thearkadia/The_Ark/README.md

# The Ark - ¿Democracy's Favorite Device?

The Ark is a portable computer that can be upgraded, modded, or repaired by the user since it uses open-source software, the pcb files are available, and the parts can be purchased individually. It is powered by the [Raspberry Pi Compute Module](https://www.raspberrypi.org/products/compute-module-3-plus-lite/), and runs a modified version of Debian.

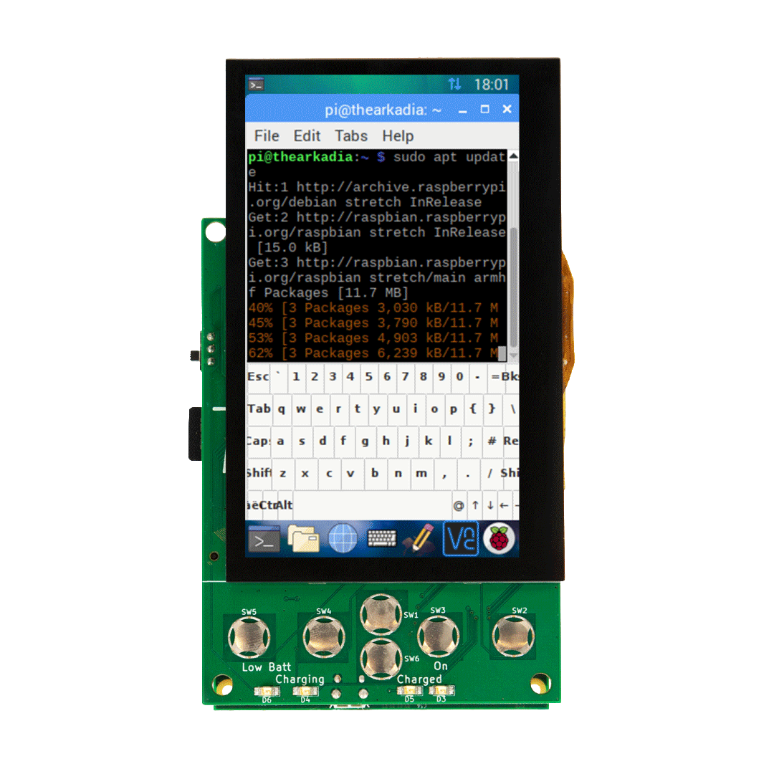
[picture p1: Media/arkscreens-final-whitebg.gif]
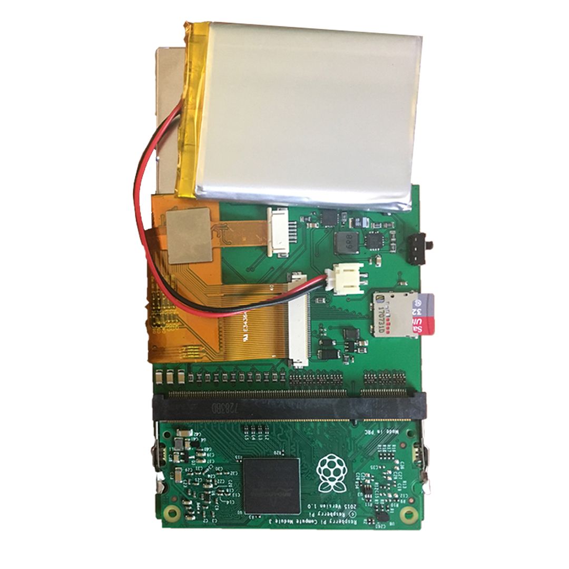
[picture p2: Media/ark-back.jpg]


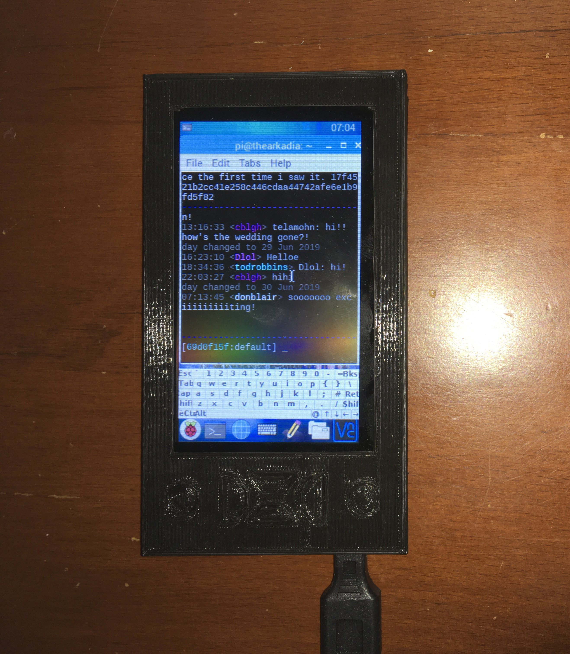
[picture p3: Media/ark-cabalchat.jpg]


# Simplifying Democracy
One of the goals of the Ark is to simplify the process of participating in a democracy for citizens, journalists, and politicians in a safe and transparent way. To simplify participating in a Democracy we will develop open source applications that focus on different key aspects of a Democracy. 

(images below are only mockups of the applications. all companies, charities, and names are used for demonstration purposes only) 

* An open source application that allows citizens to keep track of the voting history of their representatives. 

<p align="center">
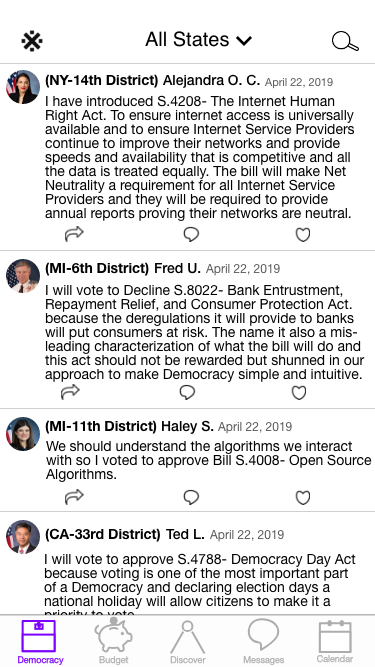
[picture p4: Media/PNGS/Posts@3x.png]
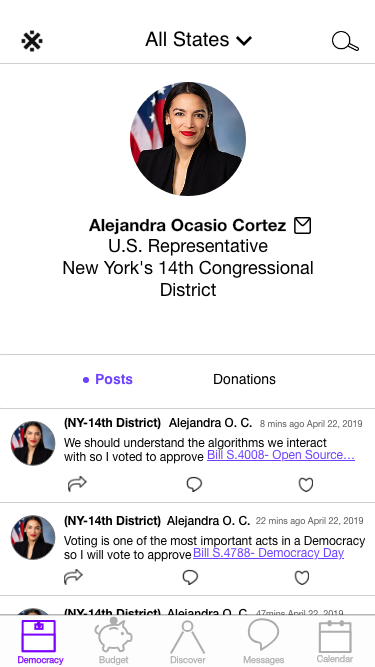
[picture p5: Media/PNGS/Profile Posts – 1@3x.png]
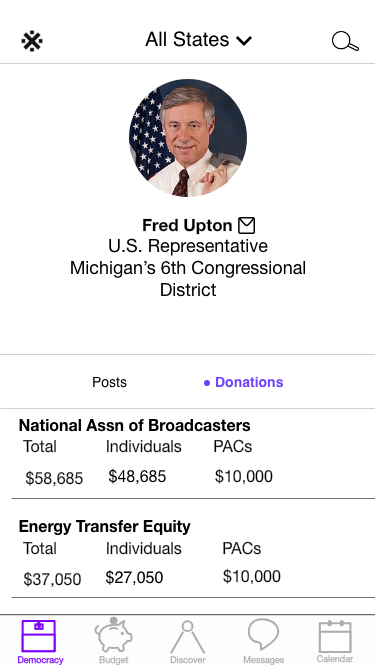
[picture p6: Media/PNGS/Profile Donations@3x.png]
       </p>

# Simplifying Budgets, Boycotts, and Taxes

* An application for journalists and charities to easily recieve reccuring donations from supporters. 

* An application to simplify the process of boycotting companies by displaying what products and companies a conglomerate owns or has a stake in. With a search feature to find alternatives to the product\service they are looking to purchase. 

<p align="center">
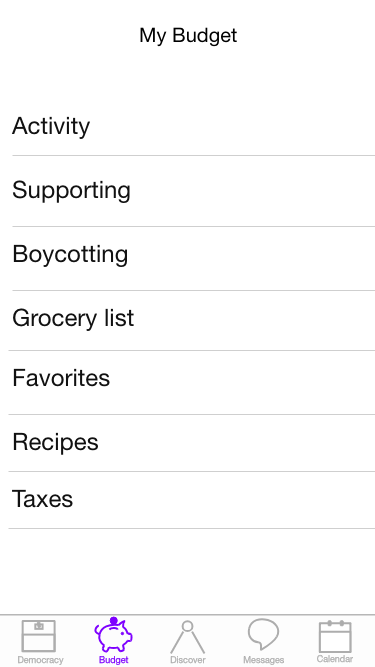
[picture p7: Media/PNGS/Budget@3x.png]

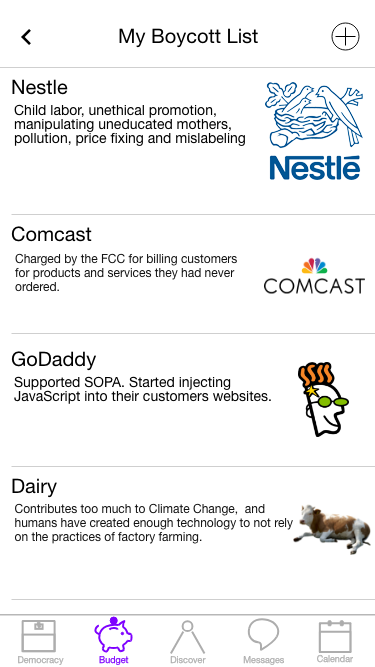
[picture p8: Media/PNGS/Boycott List@3x.png]
    
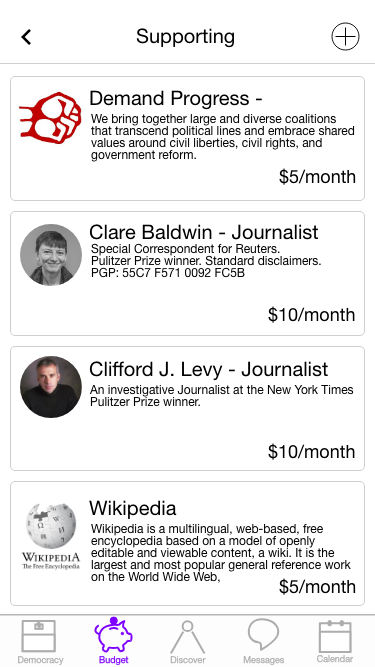
[picture p9: Media/PNGS/Supporting@3x.png]

</p>

<p align="center">
  
</p>

<p align="center">
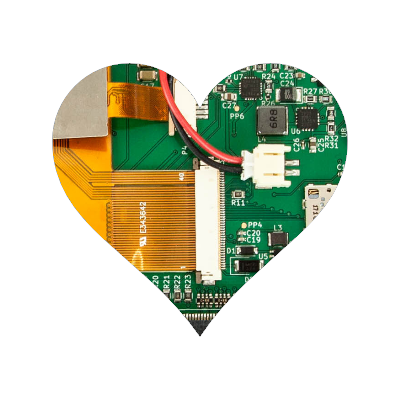
[picture p10: Media/ark-heart.png]
  
</p>
 <p align="center">
  <a href="mailto:nixoye@protonmail.com"></center>
Email Us</a> </p>

<p align="center"> <a href="https://www.crowdsupply.com/the-arkadia/the-ark-dev-kit"> Crowdsupply Campaign </center> </p></a>
<p>
 <p align="center">
  Follow us on <a href="https://instagram.com/thearkadia">Instagram </a> or <a href="http://www.twitter.com/nixoye">Twitter</a></p>
    
<p align="center">  It has to start somewhere. It has to start sometime.
      </center> 
 </p>

<p align="center"> What better place than here? What better time than now? </center>
