thearkadia/The_Ark/Media/3Dmodel/arkv1.png

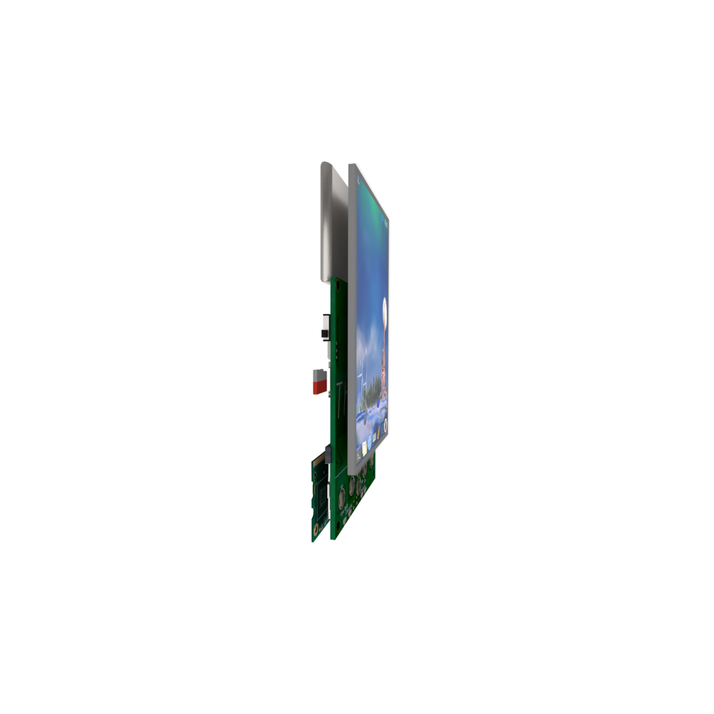
Media/3Dmodel/arkv1.png
