thearkadia/The_Ark/Media/arktitlecard.png

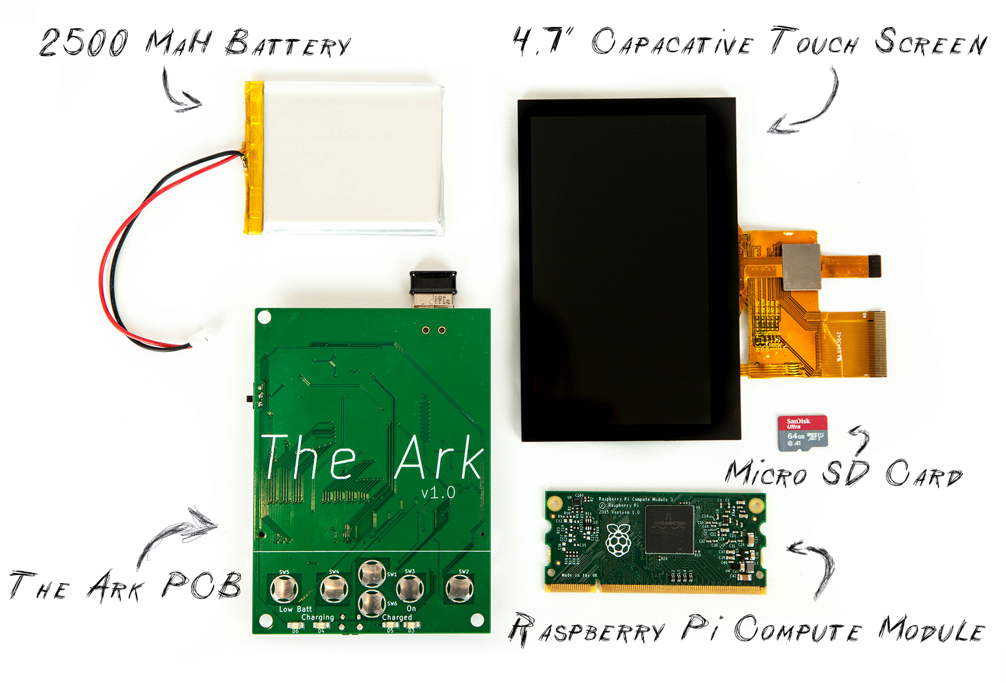
Media/arktitlecard.png
