thearkadia/The_Ark/Media/pcbimage2.png

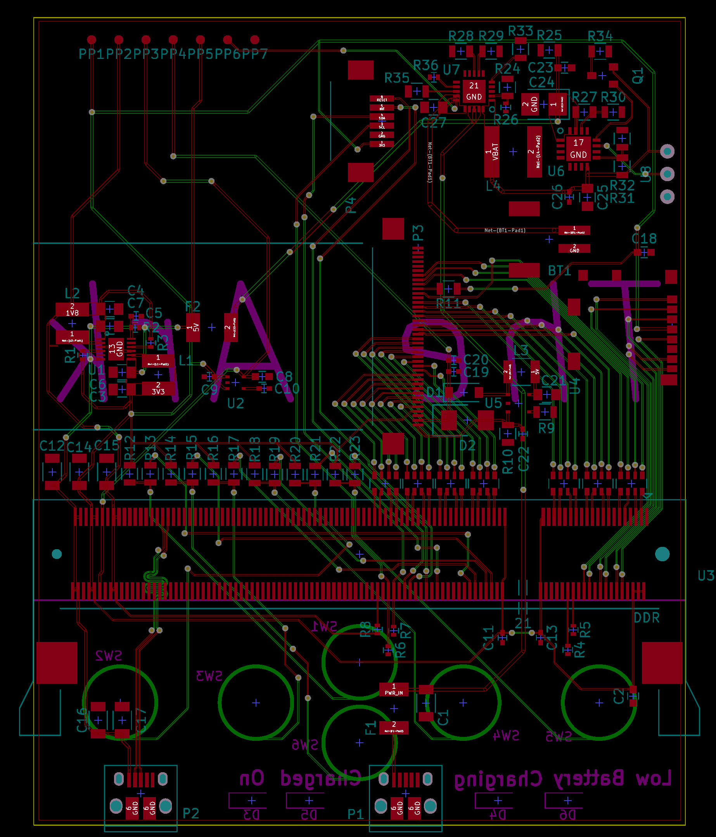
Media/pcbimage2.png
