thearkadia/The_Ark/Media/pcbimage.png

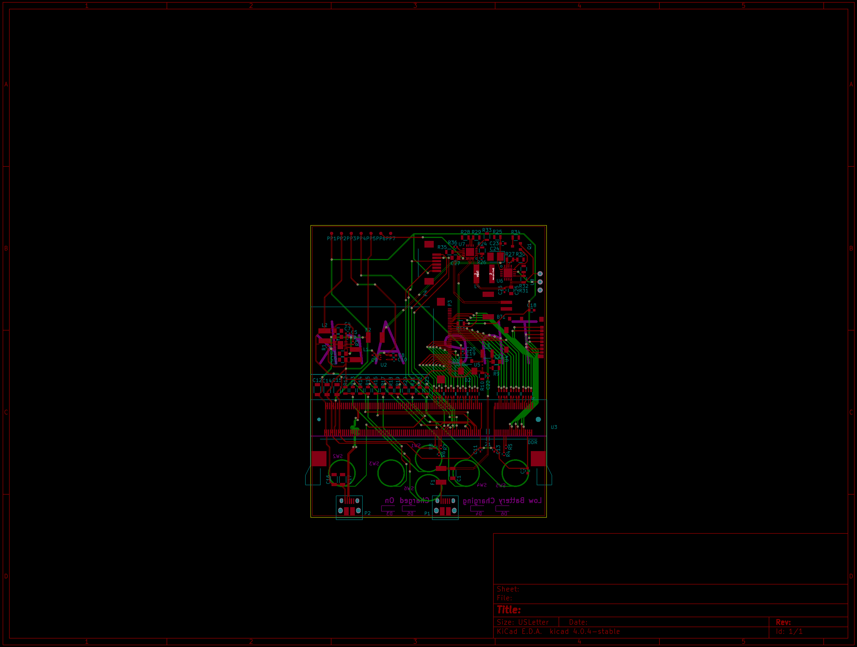
Media/pcbimage.png
