thearkadia/The_Ark/Media/PNGS/calendar@3x.png

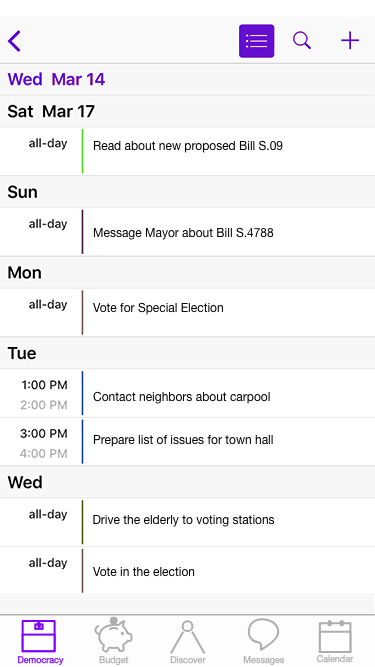
Media/PNGS/calendar@3x.png
