thearkadia/The_Ark/Media/PNGS/good samaritan sectino@3x.png

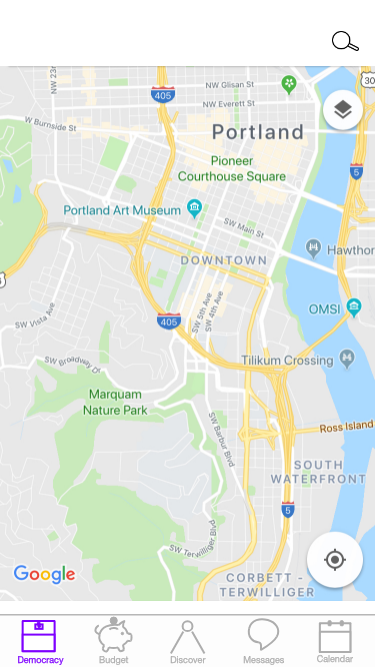
Media/PNGS/good samaritan sectino@3x.png
