thearkadia/The_Ark/Media/PNGS/Nestle Alternative Hersheys@3x.png

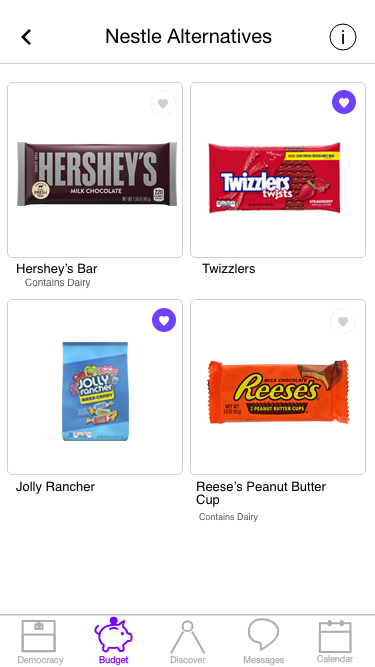
Media/PNGS/Nestle Alternative Hersheys@3x.png
