thearkadia/The_Ark/Media/PNGS/Nestle Alternatives Hershey Extended@3x.png

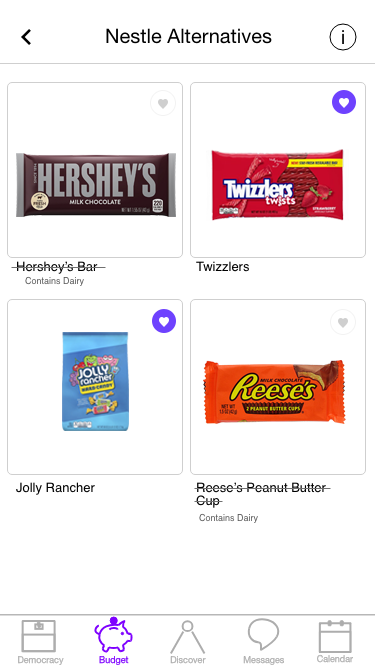
Media/PNGS/Nestle Alternatives Hershey Extended@3x.png
