thearkadia/The_Ark/Media/PNGS/Nestle Alternatives@3x.png

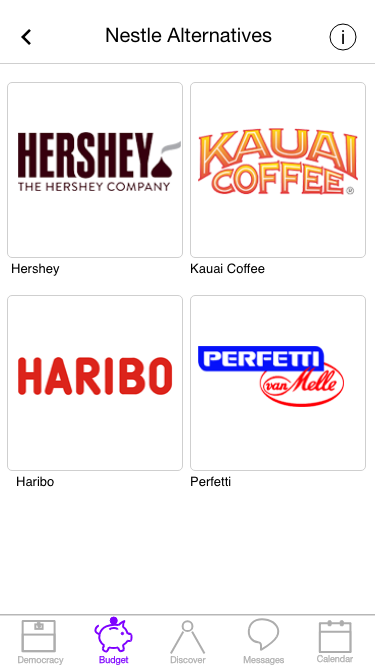
Media/PNGS/Nestle Alternatives@3x.png
