thearkadia/The_Ark/Media/PNGS/News@3x.png

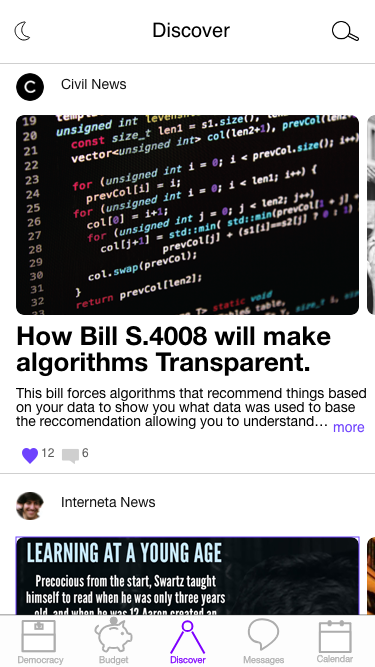
Media/PNGS/News@3x.png
