thearkadia/The_Ark/Media/PNGS/QR scanner@3x.png

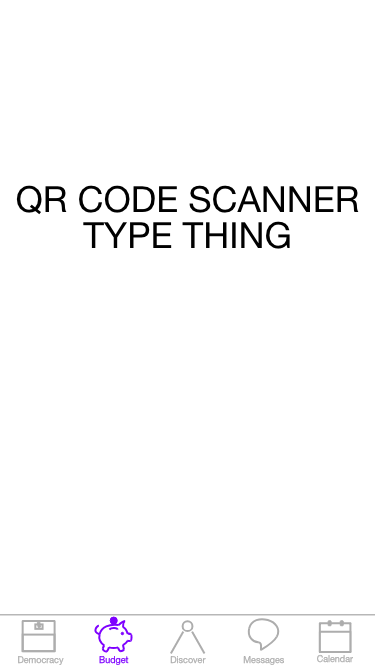
Media/PNGS/QR scanner@3x.png
