thearkadia/The_Ark/Media/PNGS/wikipedia@3x.png

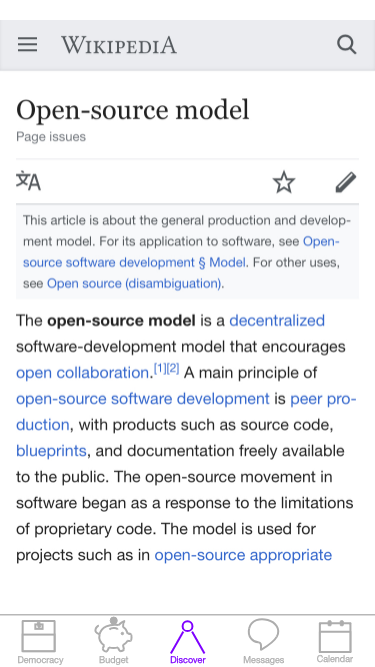
Media/PNGS/wikipedia@3x.png
