thearkadia/The_Ark/Media/screenshots/1.png

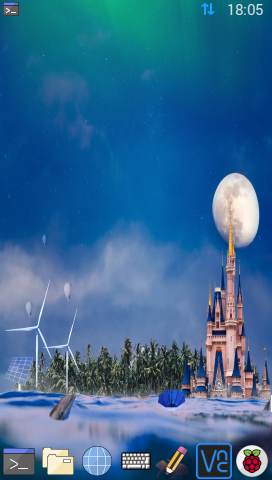
Media/screenshots/1.png
