thearkadia/The_Ark/Media/screenshots/2.png

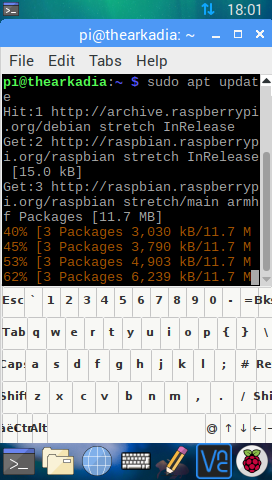
Media/screenshots/2.png
