thearkadia/The_Ark/Media/screenshots/3.png

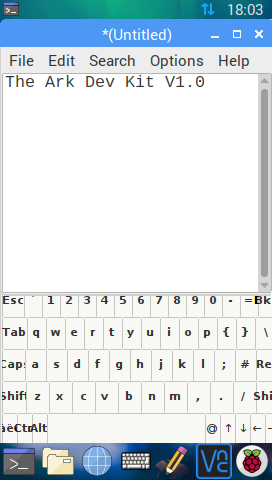
Media/screenshots/3.png
