thearkadia/The_Ark/Media/screenshots/4.png

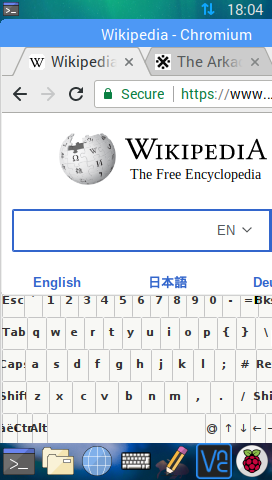
Media/screenshots/4.png
