thearkadia/The_Ark/Media/screenshots/n0.png

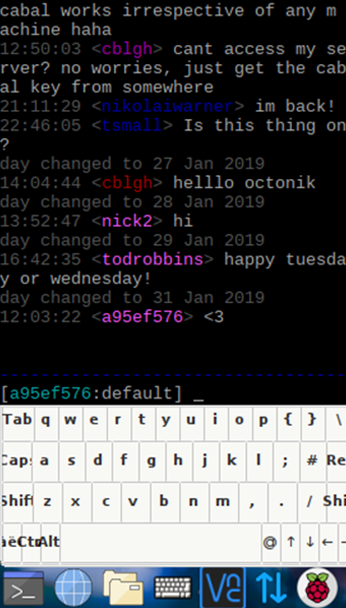
Media/screenshots/n0.png
