thearkadia/The_Ark/BOM.xls

Sub-Assembly | Description | Part | Value | Package | Quantity | Link | Footprint Checked | Component
Pi Compute Module | SODIMM | A114854-ND | - | - | 1 | http://www.digikey.com/product-detail/en/te-connectivity-amp-connectors/1473149-4/A114854-ND/1890696 |  | U3
 | Resistor |  | 100k | 0402 | 5 | http://www.digikey.com/product-detail/en/panasonic-electronic-components/ERJ-2RKF1003X/P100KLCT-ND/194127 |  | R4, R5, R6, R7, R8
 | Capacitor |  | 4.7uF | 0603 | 2 | http://www.digikey.com/product-detail/en/samsung-electro-mechanics-america-inc/CL10B475KQ8NQNC/1276-2087-1-ND/3890173 |  | C2, C18
 | uSD Card Slot | WM6357CT-ND | - | - | 1 | http://www.digikey.com/product-detail/en/molex-llc/1040310811/WM6357CT-ND/2804769 |  | U4
 | Micro USB |  | - | - | 1 | http://www.digikey.com/product-detail/en/amphenol-fci/10103594-0001LF/609-4050-1-ND/2350357 |  | P2
Power Supplies | Fuse | MF-MSMF200-2CT-ND | 2A | - | 1 | http://www.digikey.com/product-detail/en/bourns-inc/MF-MSMF200-2/MF-MSMF200-2CT-ND/662850 |  | F1
 | Capacitor |  | 47uF | 1206 | 6 | http://www.digikey.com/product-detail/en/murata-electronics-north-america/GRM31CR60J476KE19L/490-6508-1-ND/3845705 |  | C1, C12, C14, C15, C16, C17
 | Capacitor |  | 100nF | 0402 | 2 | http://www.digikey.com/product-detail/en/kemet/C0402C104K9RACTU/399-4872-1-ND/1090867 |  | C5, C10
 | Capacitor |  | 10uF | 0805 | 4 | http://www.digikey.com/product-detail/en/murata-electronics-north-america/GRM219R60J106KE19D/490-3340-1-ND/702881 |  | C3, C4, C6, C7
 | Capacitor |  | 1uF | 0402 | 3 | http://www.digikey.com/product-detail/en/taiyo-yuden/JMK105BJ105KV-F/587-1231-1-ND/931008 |  | C9, C11, C13
 | Capacitor |  | 4.7uF | 0603 | 1 | http://www.digikey.com/product-detail/en/samsung-electro-mechanics-america-inc/CL10B475KQ8NQNC/1276-2087-1-ND/3890173 |  | C8
 | Resistor |  | 0R | 0402 | 2 | http://www.digikey.com/product-detail/en/panasonic-electronic-components/ERJ-2GE0R00X/P0.0JCT-ND/146726 |  | R1, R3
 | Resistor |  | 100k | 0402 | 1 | http://www.digikey.com/product-detail/en/panasonic-electronic-components/ERJ-2RKF1003X/P100KLCT-ND/194127 |  | R2
 | Inductor |  | 4.7uH 2A | - | 2 | http://www.digikey.com/product-detail/en/bourns-inc/SRN4018-4R7M/SRN4018-4R7MCT-ND/3821520 |  | L1, L2
 | Micro USB |  | - | - | 1 | http://www.digikey.com/product-detail/en/amphenol-fci/10103594-0001LF/609-4050-1-ND/2350357 |  | P1
 | 3v3 and 1v8 Regul | PAM2306AYPKE | - | - | 1 | http://www.mouser.com/ProductDetail/Diodes-Incorporated/PAM2306AYPKE/?qs=QK%2FAlAnD7r6vC0KF37wC2Q%3D%3D |  | U1
 | 2v5 Regul | AP7115-25SEG-7 | - | - | 1 | http://www.mouser.com/ProductDetail/Diodes-Incorporated/AP7115-25SEG-7/?qs=oUsD4qhOtFzl3uIiEMdYbQ%3D%3D |  | U2
Screen and Connector | LCD Screen |  | - | - | 1 |  |  | -
 | 40 Pin Connector | WM3431CT-ND | - | - | 1 | http://www.digikey.com/product-detail/en/molex-llc/0541044031/WM3431CT-ND/2405801 |  | P3
 | 6 Pin Connector |  | - | - | 1 |  |  | P4
 | Resistor Array |  | 33R | 1206 | 7 | http://www.digikey.com/product-detail/en/bourns-inc/CAY16-33R0F4LF/CAY16-33R0F4LFDKR-ND/5775070 |  | RP1 - RP7
 | Resistor |  | 10k | 0805 | 2 | http://www.digikey.com/product-detail/en/yageo/RC0805FR-0710KL/311-10.0KCRCT-ND/730482 |  | R9, R11
 | Resistor |  | 12R | 0805 | 1 | http://www.digikey.com/product-detail/en/yageo/RC0805FR-0712RL/311-12.0CRCT-ND/730514 |  | R10
 | Capacitor |  | 10uF | 0805 | 1 | http://www.digikey.com/product-detail/en/murata-electronics-north-america/GRM219R60J106KE19D/490-3340-1-ND/702881 |  | C21
 | Capacitor |  | 1uF | 0402 | 2 | http://www.digikey.com/product-detail/en/taiyo-yuden/JMK105BJ105KV-F/587-1231-1-ND/931008 |  | C19, C20
 | Capacitor |  | 100nF | 0402 | 1 | http://www.digikey.com/product-detail/en/kemet/C0402C104K9RACTU/399-4872-1-ND/1090867 |  | C22
 | Inductor | BRL3225T150K | - | - | 1 | http://www.digikey.com/product-detail/en/taiyo-yuden/BRL3225T150K/587-3027-1-ND/2763398 |  | L3
 | Diode | MBR0540 | - | - | 1 | http://www.digikey.com/product-detail/en/fairchild-on-semiconductor/MBR0540/MBR0540CT-ND/3042807 |  | D1
 | Diode | SMAZ24-TP | - | - | 1 | https://www.digikey.com/product-detail/en/micro-commercial-co/SMAZ24-TP/SMAZ24-TPMSCT-ND/1636198 |  | D2
 | LED Regul | FAN5333BSX | - | - | 1 | http://www.digikey.com/product-detail/en/fairchild-on-semiconductor/FAN5333BSX/FAN5333BSXCT-ND/3042778 |  | U5
Button Pad | Dome SW |  | - | - | 6 | https://www.digikey.com/product-detail/en/keystone-electronics/5133TR/36-5133CT-ND/6834345 |  | SW1 - SW6
 | Resistor |  | 10k | 0805 | 6 | http://www.digikey.com/product-detail/en/yageo/RC0805FR-0710KL/311-10.0KCRCT-ND/730482 |  | R12, R14, R16, R18, R20, R22
 | Resistor |  | 1k | 0805 | 6 | http://www.digikey.com/product-detail/en/yageo/RC0805FR-071KL/311-1.00KCRCT-ND/730391 |  | R13, R15, R17, R19, R21, R23
Battery Management | Charging Controller | MCP73871 | - | - | 1 | https://www.digikey.com/product-detail/en/microchip-technology/MCP73871-2CCI-ML/MCP73871-2CCI-ML-ND/1680971 |  | U7
 | Voltage Booster | TPS61090RSAR | - | - | 1 | https://www.digikey.com/product-detail/en/texas-instruments/TPS61090RSAR/296-15259-1-ND/566899 |  | U6
 | Capacitor |  | 10uF | 0805 | 2 | http://www.digikey.com/product-detail/en/murata-electronics-north-america/GRM219R60J106KE19D/490-3340-1-ND/702881 |  | C25, C27
 | Capacitor |  | 100nF | 0402 | 1 | http://www.digikey.com/product-detail/en/kemet/C0402C104K9RACTU/399-4872-1-ND/1090867 |  | C26
 | Capacitor |  | 2.2uF | 0603 | 1 | https://www.digikey.com/product-detail/en/yageo/CC0603KRX5R5BB225/311-1449-1-ND/2833755 |  | C23
 | Electrolytic Capacitor |  | 100uF | 1411 | 1 | https://www.digikey.com/product-detail/en/avx-corporation/F930J107KBA/478-8153-1-ND/4005595 |  | C24
 | Resistor |  | 1.87M | 0805 | 2 | https://www.digikey.com/product-detail/en/panasonic-electronic-components/ERJ-6ENF1874V/P1.87BTCT-ND/4429149 |  | R27, R31
 | Resistor |  | 340k | 0805 | 1 | https://www.digikey.com/product-detail/en/yageo/RC0805FR-07340KL/311-340KCRCT-ND/730822 |  | R32
 | Resistor |  | 200k | 0805 | 1 | https://www.digikey.com/product-detail/en/yageo/RC0805FR-07200KL/311-200KCRCT-ND/730671 |  | R30
 | Resistor |  | 1k | 0805 | 5 | http://www.digikey.com/product-detail/en/yageo/RC0805FR-071KL/311-1.00KCRCT-ND/730391 |  | R25, R28, R29, R34, R35
 | Resistor |  | 270k | 0805 | 1 | https://www.digikey.com/product-detail/en/yageo/RC0805FR-07270KL/311-270KCRCT-ND/730731 |  | R24
 | Resistor |  | 100k | 0402 | 2 | http://www.digikey.com/product-detail/en/panasonic-electronic-components/ERJ-2RKF1003X/P100KLCT-ND/194127 |  | R26, R36
 | Resistor |  | 15k | 0805 | 1 | https://www.digikey.com/product-detail/en/yageo/RC0805FR-0715KL/311-15.0KCRCT-ND/730555 |  | R33
 | Inductor | ASPI-0615FS-6R8M-T2 | 6.8uH | - | 1 | https://www.digikey.com/product-detail/en/abracon-llc/ASPI-0615FS-6R8M-T2/535-10777-1-ND/2619440 |  | L4
 | Transistor | MMUN2133LT1G | - | - | 1 | https://www.digikey.com/product-detail/en/on-semiconductor/MMUN2133LT1G/MMUN2133LT1GOSCT-ND/2705149 |  | Q1
 | Switch | MHSS1105 | SPDT | - | 1 | https://www.digikey.com/product-detail/en/apem-inc/MHSS1105/679-1849-ND/1949465 |  | U8
 | LED |  | - | 1206 | 4 | https://www.digikey.com/product-detail/en/lite-on-inc/LTST-C150GKT/160-1169-1-ND/269241 |  | D3 - D6
 | Battery Connector |  | - | - | 1 | https://www.digikey.com/product-detail/en/jst-sales-america-inc/S2B-PH-SM4-TB(LF)(SN)/455-1749-1-ND/926846 |  | BT1
 | Fuse | MF-MSMF200-2CT-ND | 2A | - | 1 | http://www.digikey.com/product-detail/en/bourns-inc/MF-MSMF200-2/MF-MSMF200-2CT-ND/662850 |  | F2
Total
