thearkadia/The_Ark/Files/arkcase-snapclose-j/print-files/bottom-case.stl

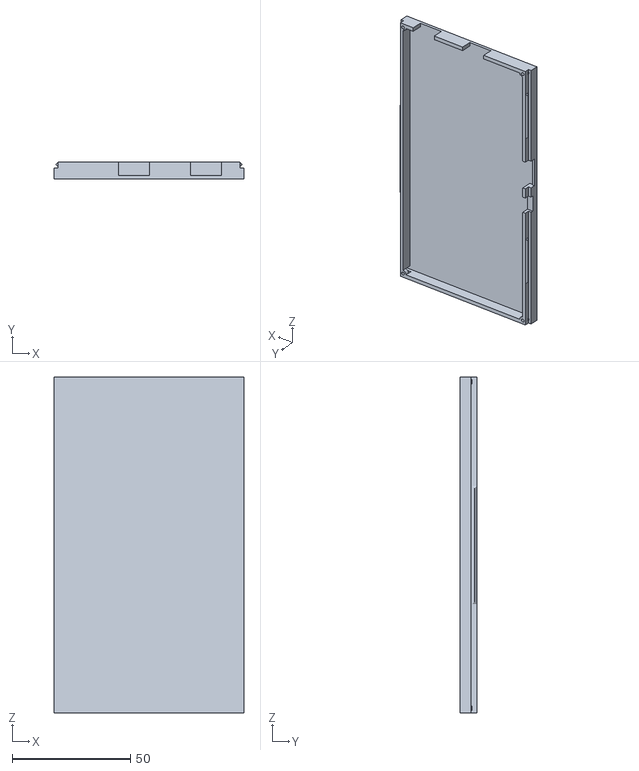
[picture p29: CAD file, 2019-07-02]
Files/arkcase-snapclose-j/print-files/bottom-case.stl
80.3 x 7.13 x 142.3
