thearkadia/The_Ark/Files/arkcase-snapclose-j/print-files/top-case.stl

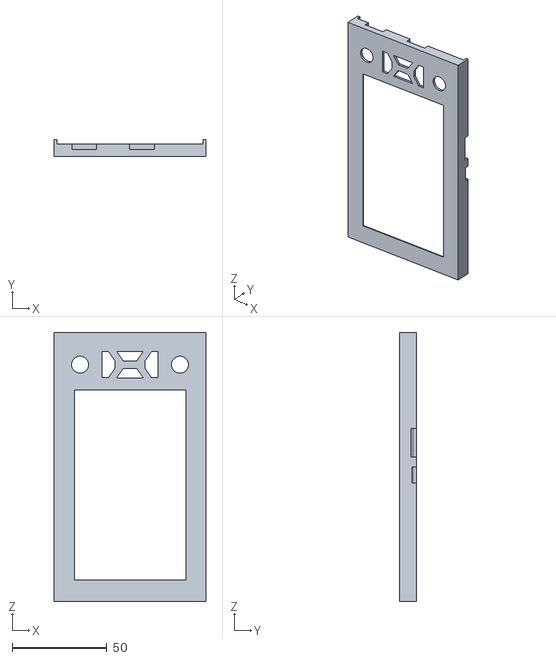
[picture p30: CAD file, 2019-07-02]
Files/arkcase-snapclose-j/print-files/top-case.stl
80.3 x 9.22 x 142.3
