thearkadia/The_Ark/Files/arkcase-snapclose-j/print-files/Button A.stl

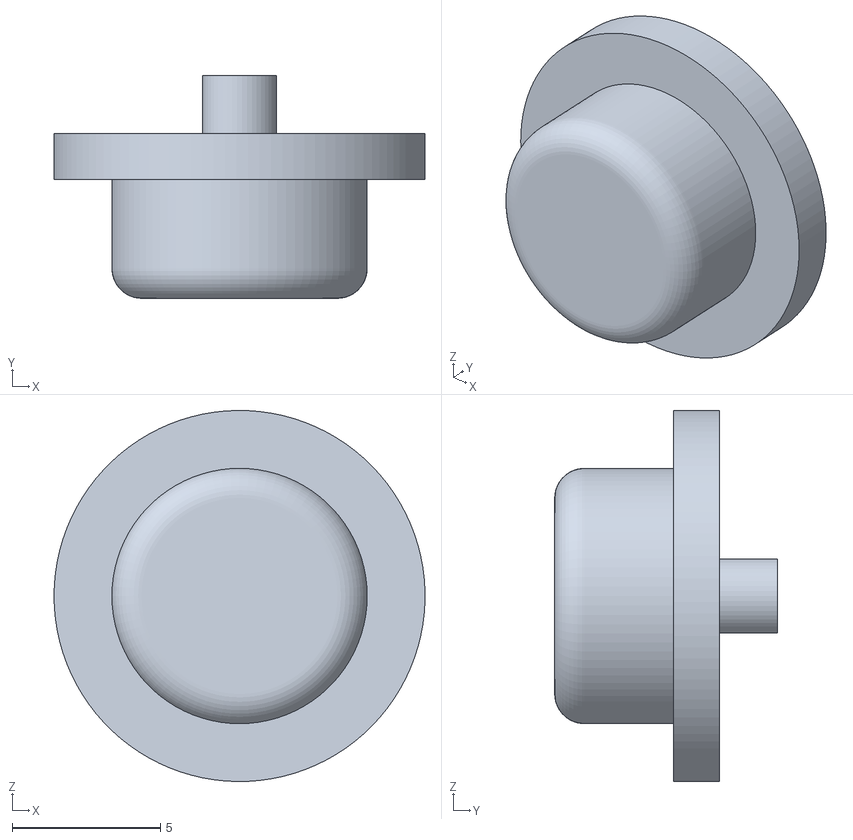
[picture p31: CAD file, 2019-07-02]
Files/arkcase-snapclose-j/print-files/Button A.stl
12.5 x 7.50 x 12.5
