thearkadia/The_Ark/Files/arkcase-snapclose-j/print-files/Button Arrows.stl

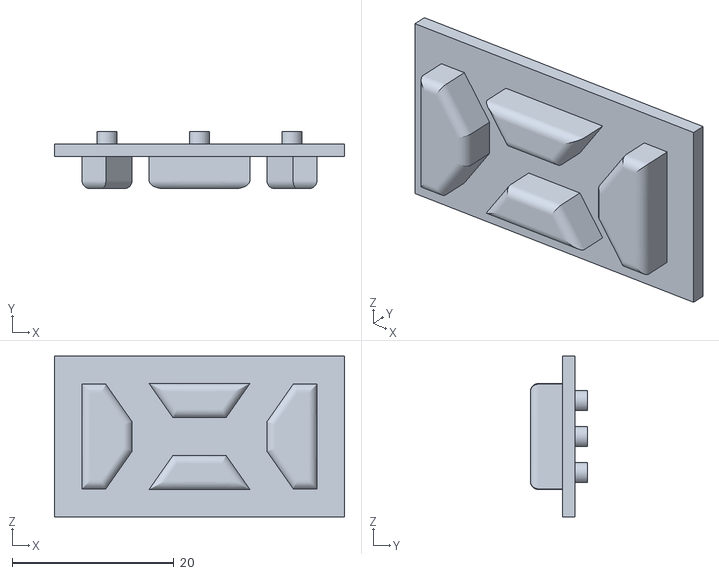
[picture p32: CAD file, 2019-07-02]
Files/arkcase-snapclose-j/print-files/Button Arrows.stl
35.9 x 7.10 x 19.9
