thearkadia/The_Ark/(list of files, cad)

Other CAD files:
Files/arkcase-snapclose-j/print-files/Button B.stl
Files/3Dprintable_Case_Design.f3d
Files/arkcase-snapclose-j/arkcase-j-snapclose.f3d
