thearkadia/The_Ark/Schematics/Ark.kicad_pcb

## KiCad design Schematics/Ark.kicad_pcb (2018-07-02)

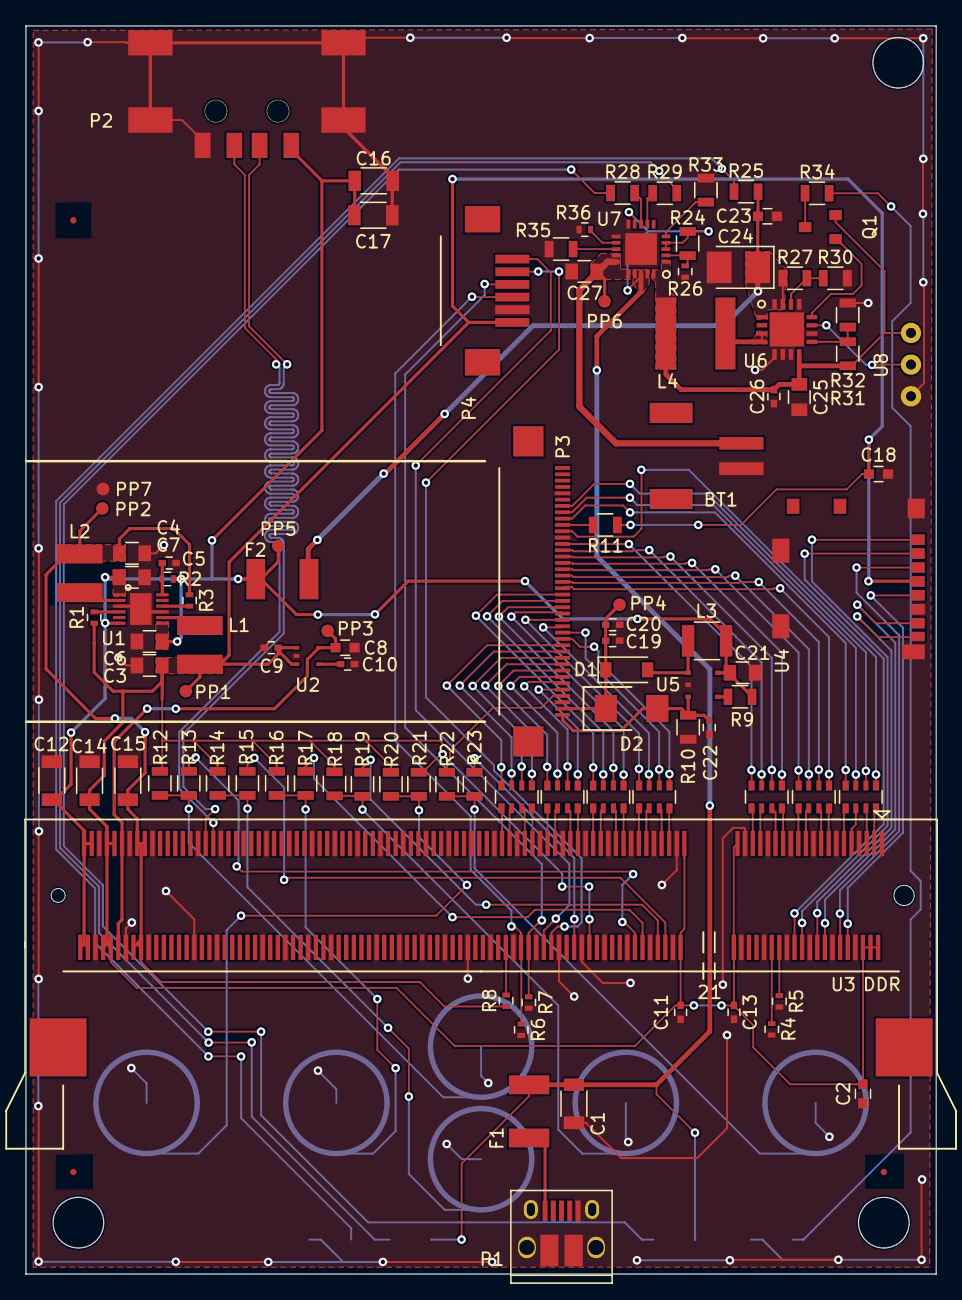
[picture p33: board Ark.kicad_pcb from above]

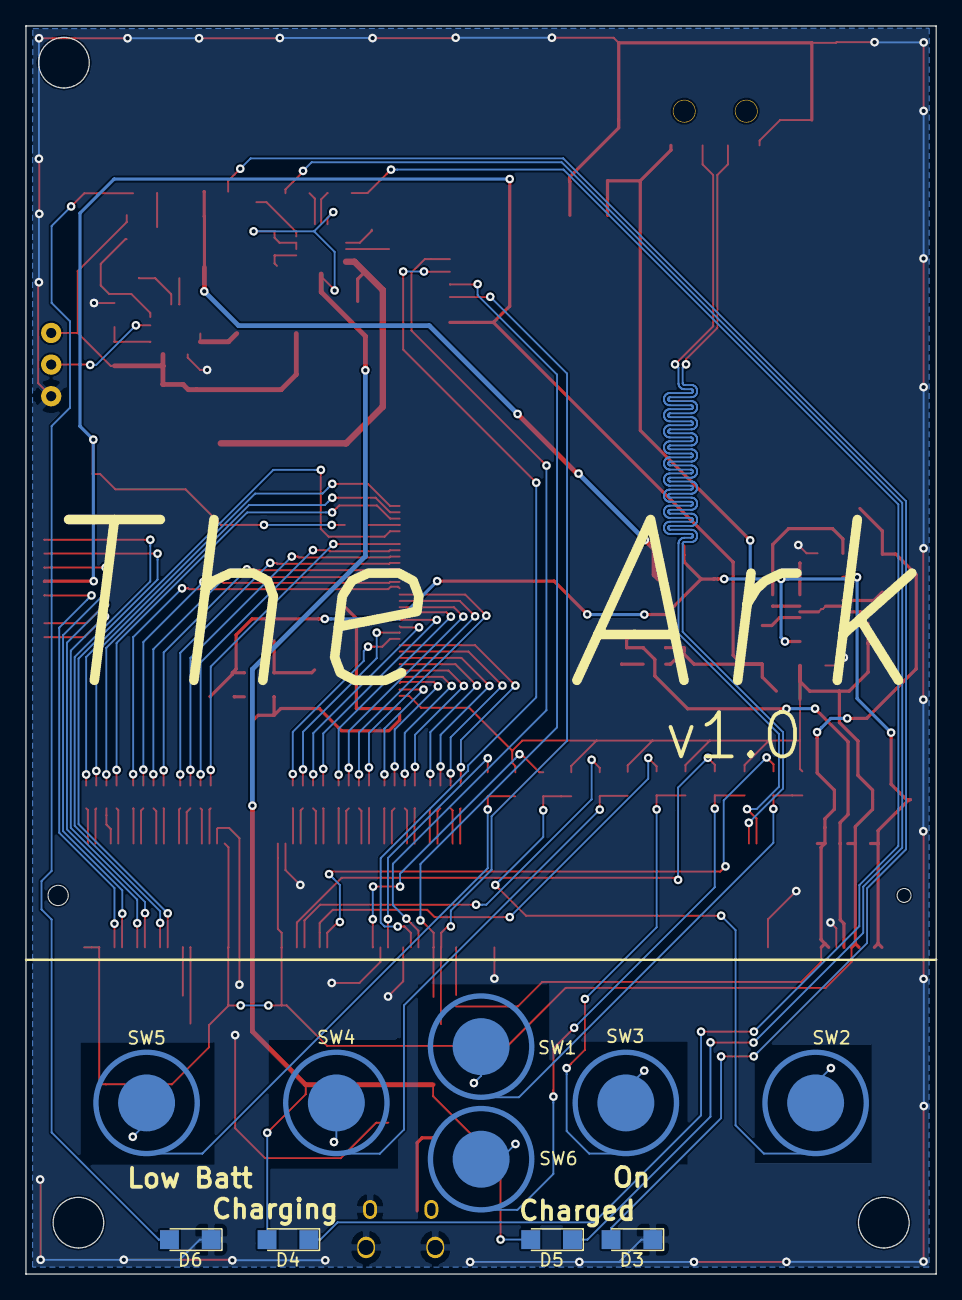
[picture p34: board Ark.kicad_pcb from below]

Board: 2 copper layers, 71.9 x 98.6 mm, 112 parts (10 on the bottom side), 120 nets.

Parts:
BT1: JST 2-PH; JST_2_PH
C1, C12, C14, C15, C16, C17: 47uF; C_1206
C2, C8, C18: 4.7uF; C_0603
C3, C4, C6, C7, C21, C25, C27: 10uF; C_0805
C5, C10, C22, C26: 100nF; C_0402
C9, C11, C13, C19, C20: 1uF; C_0402
C23: 2.2uF; C_0603
C24: 100uF; CP_Tantalum_Case-B_EIA-3528-21_Reflow
D1: MBR0540; D_SOD-123
D2: SMAZ24-TP
D3: Blue; LED_1206
D4: Orange; LED_1206
D5: Green; LED_1206
D6: Red; LED_1206
F1, F2: MF-MSMF200
L1, L2: 4.7uH; SRN4018-4R7M
L3: BRL3225T150K; C_1210
L4: 6.8uH; ASPI-0615FS-6R8M-T2
P1: USB_OTG; USB_Micro-B_10103594-0001LF
P2: USB_A; Wurth_USB_732-11179-1-ND
P3: 40_Pin_LCD_Out; LCD_Molex_Connector
P4: 6_Pin_Touch_In; Touch_Molex_Connector
P5, P6, P7: CONN_01X01; Fiducial
PP1, PP2, PP3, PP4, PP5, PP6, PP7: Test_Point
Q1: MMUN2133LT1G
R1, R3: 0R; R_0402
R2, R4, R5, R6, R7, R8, R26, R36: 100k; R_0402
R9, R11, R12, R14, R16, R18, R20, R22: 10k; R_0805
R10: 12; R_0805
R13, R15, R17, R19, R21, R23, R25, R28, R29, R34, R35: 1k; R_0805
R24: 270k; R_0805
R27, R31: 1.87M; R_0805
R30: 200k; R_0805
R32: 340k; R_0805
R33: 15k; R_0805
RP1, RP2, RP3, RP4, RP5, RP6, RP7: 33 R_PACK4; R_Array_Convex_4x0603
SW1, SW2, SW3, SW4, SW5, SW6: SW_PUSH_SMALL_H; Snapdome_SW
U1: PAM2306AYPKE
U2: AP7115-25SEG; AP7115-25SEG-7
U3: DDR2_SODIMM_CM_3_Lite; Socket_SODIMM_DDR2
U4: 1040310811; uSD_1040310811
U5: FAN5333BSX
U6: TPS61090RSAR
U7: MCP73871
U8: SPDT_switch; spdt_switch_MHSS1105

Connections:
1V8: C4.1, C15.1, L2.2, PP2.1, R3.1, R8.2, U3.183, U3.184, U3.185, U3.186
3V3: C2.1, C3.1, C9.1, C11.1, C13.1, C14.1, C18.1, L1.2, P3.4, P4.1, PP1.1, R1.1, R11.1, R12.2, R14.2, R16.2, R18.2, R20.2, R22.2, U2.1, U2.3, U3.2, U3.4, U3.6, U3.39, U3.40, U3.41, U3.42, U3.191, U3.192, U3.193, U3.194, U4.4
5V: C6.1, C7.1, C12.1, C16.1, C17.1, C21.1, F2.1, L3.1, P2.1, PP5.1, R2.1, R9.2, U1.1, U1.6, U1.7, U3.197, U3.198, U3.199, U3.200, U5.5
24V: C19.2, C20.2, D1.1, D2.1, P3.2, PP4.1
A: R21.2, U3.66
A_IN: R20.1, R21.1, SW2.1
B: R23.2, U3.70
B0: RP5.8, U3.15
B1: RP5.7, U3.17
B2: RP5.6, U3.21
B3: RP5.5, U3.23
B4: RP6.8, U3.27
B5: RP6.7, U3.29
B6: RP6.6, U3.33
B7: RP6.5, U3.35
B_IN: R22.1, R23.1, SW5.1
CM_VDAC: C8.1, PP3.1, U2.5, U3.189, U3.190
DE: RP7.7, U3.5
DOWN: R15.2, U3.46
DOWN_IN: R14.1, R15.1, SW6.1
EN_PWR: U6.11, U8.2
G0: RP3.8, U3.45
G1: RP3.7, U3.47
G2: RP3.6, U3.51
G3: RP3.5, U3.53
G4: RP4.8, U3.57
G5: RP4.7, U3.59
G6: RP4.6, U3.63
G7: RP4.5, U3.65
GND: BT1.2, C1.2, C2.2, C3.2, C4.2, C5.2, C6.2, C7.2, C8.2, C9.2, C10.2, C11.2, C12.2, C13.2, C14.2, C15.2, C16.2, C17.2, C18.2, C19.1, C20.1, C21.2, C22.2, C23.2, C24.2, C25.2, C26.2, C27.2, D3.1, D6.1, P1.5, P1.6, P2.4, P2.5, P3.3, P3.29, P3.36, P4.2, PP7.1, R4.2, R5.2, R6.2, R7.2, R10.1, R26.2, R30.2, R32.2, R33.2, R35.2, R36.2, SW1.2, SW2.2, SW3.2, SW4.2, SW5.2, SW6.2, U1.3, U1.9, U1.13, U2.2, U3.1, U3.7, U3.8, U3.13, U3.14, U3.19, U3.20, U3.25, U3.26, U3.31, U3.32, U3.37, U3.38, U3.43, U3.44, U3.49, U3.50, U3.55, U3.56, U3.61, U3.62, U3.67, U3.68, U3.73, U3.74, U3.79, U3.80, U3.85, U3.86, U3.91, U3.92, U3.97, U3.98, U3.103, U3.104, U3.109, U3.110, U3.115, U3.116, U3.121, U3.122, U3.127, U3.133, U3.134, U3.139, U3.140, U3.145, U3.146, U3.151, U3.152, U3.157, U3.163, U3.164, U3.169, U3.170, U3.181, U3.182, U3.187, U3.188, U3.195, U3.196, U4.6, U4.11, U4.12, U4.13, U4.14, U5.2, U6.5, U6.6, U6.7, U6.10, U6.13, U6.17, U7.10, U7.11, U7.21, U8.1
HSYNC: RP7.5, U3.11
INT: P4.5, U3.76
LEDK: C22.1, D2.2, P3.1, R10.2, U5.3
LEFT: R17.2, U3.52
LEFT_IN: R16.1, R17.1, SW3.1
unnamed: BT1.1, C27.1, PP6.1, U7.14, U7.15, U7.16
unnamed: C5.1, R2.2, U1.12
unnamed: C10.1, U2.4
unnamed: C23.1, C24.1, F2.2, R25.1, R27.1, U6.1, U6.15, U6.16
unnamed: D1.2, L3.2, U5.1
unnamed: D3.2, R25.2
unnamed: D4.1, R28.1
unnamed: D5.1, R29.1
unnamed: D6.2, R34.2
unnamed: F1.2, P1.1
unnamed: L1.1, U1.8
unnamed: L2.1, U1.2
unnamed: L4.2, U6.3, U6.4
unnamed: P3.5, RP1.1
unnamed: P3.6, RP1.2
unnamed: P3.7, RP1.3
unnamed: P3.8, RP1.4
unnamed: P3.9, RP2.1
unnamed: P3.10, RP2.2
unnamed: P3.11, RP2.3
unnamed: P3.12, RP2.4
unnamed: P3.13, RP3.1
unnamed: P3.14, RP3.2
unnamed: P3.15, RP3.3
unnamed: P3.16, RP3.4
unnamed: P3.17, RP4.1
unnamed: P3.18, RP4.2
unnamed: P3.19, RP4.3
unnamed: P3.20, RP4.4
unnamed: P3.21, RP5.1
unnamed: P3.22, RP5.2
unnamed: P3.23, RP5.3
unnamed: P3.24, RP5.4
unnamed: P3.25, RP6.1
unnamed: P3.26, RP6.2
unnamed: P3.27, RP6.3
unnamed: P3.28, RP6.4
unnamed: P3.30, RP7.1
unnamed: P3.31, R11.2
unnamed: P3.32, RP7.4
unnamed: P3.33, RP7.3
unnamed: P3.34, RP7.2
unnamed: Q1.1, U6.12
unnamed: Q1.3, R34.1
unnamed: R1.2, U1.4
unnamed: R3.2, U1.10
unnamed: R4.1, U3.30
unnamed: R5.1, U3.28
unnamed: R8.1, U3.88
unnamed: R9.1, U5.4
unnamed: R24.2, R26.1, U7.2
unnamed: R27.2, R30.1, U6.14
unnamed: R28.2, U7.8
unnamed: R29.2, U7.7
unnamed: R31.2, R32.1, U6.9
unnamed: R33.1, U7.5
unnamed: R35.1, U7.13
unnamed: R36.1, U7.12
ODCK: RP7.8, U3.3
PWR_IN: C1.1, D4.2, D5.2, F1.1, R24.1, U7.3, U7.4, U7.9, U7.17, U7.18, U7.19
R0: RP1.8, U3.69
R1: RP1.7, U3.71
R2: RP1.6, U3.75
R3: RP1.5, U3.77
R4: RP2.8, U3.81
R5: RP2.7, U3.83
R6: RP2.6, U3.87
R7: RP2.5, U3.89
RESET: P4.6, U3.78
RIGHT: R19.2, U3.48
RIGHT_IN: R18.1, R19.1, SW4.1
SCL: P4.3, R6.1, U3.84
SDA: P4.4, R7.1, U3.82
SDX_CLK: U3.10, U4.5
SDX_CMD: U3.12, U4.3
SDX_D0: U3.16, U4.7
SDX_D1: U3.18, U4.8
SDX_D2: U3.22, U4.1
SDX_D3: U3.24, U4.2
UP: R13.2, U3.54
UP_IN: R12.1, R13.1, SW1.1
USB_D+: P2.3, U3.165
USB_D-: P2.2, U3.167
VBAT: C25.1, C26.1, L4.1, Q1.2, R31.1, U6.8, U7.1, U7.20, U8.3
VSYNC: RP7.6, U3.9
