thearkadia/The_Ark/Distro/config.txt

# For more options and information see
# http://rpf.io/configtxtreadme
# Some settings may impact device functionality. See link above for details

dtoverlay=buttons
dtoverlay=touchscreen
dtoverlay=i2c1-bcm2708,sda1_pin=44,scl1_pin=45,pin_func=6
dtoverlay=dpi24
dtoverlay=pullup

# Enable audio (loads snd_bcm2835)
dtparam=audio=on
dtparam=spi=off

overscan_left=0
overscan_right=0
overscan_top=0
overscan_bottom=0
framebuffer_width=272
framebuffer_height=480
enable_dpi_lcd=1
display_default_lcd=1
display_rotate=1
dpi_group=2
dpi_mode=87
dpi_output_format=0x6f007
hdmi_timings=480 0 2 41 2 272 0 2 10 2 0 0 0 73 0 9600000 3
overscan_scale=1
