thearkadia/The_Ark/(commit log)

2018-04-03 cleaning up the repo
    [Ark.kicad_pcb, Ark.sch, BOM.xls, Page1.sch, Page2.sch, Page3.sch, Page4.sch, config.txt]
2018-04-03 folder
    added files to folder so repo is cleaner
    [Ark.kicad_pcb, Ark.sch, BOM.xls, Page1.sch, Page2.sch, Page3.sch, Page4.sch]
2018-04-03 folder
    added files to folders so the repo is cleaner
    [Ark.kicad_pcb, Ark.sch, BOM.xls, Page1.sch, Page2.sch, Page3.sch, Page4.sch]
2018-04-03 Bills Of Materials
    [BOM.xls]
2018-04-04 3D printable case
    [3Dprintable_Case_Design.f3d]
2018-04-04 files to boot up
    [config.txt]
2018-04-04 screenshots of pcb design
